makerviet/maker-bot/README.md

# MakerBot - Thiết kế phần cứng cho VIA MakerBot các phiên bản

Các thiết kế của mạch Makerbot sẽ được cập nhật trong thời gian tới.
- MakerBot Mini.
- MakerBot V2, V3.

Tài liệu dự án: <https://via.makerviet.org/>.
