makerviet/maker-bot/images/DC2.jpg

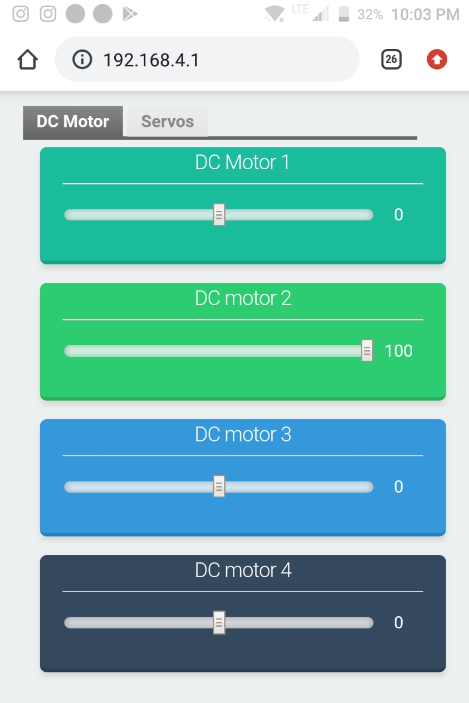
images/DC2.jpg
