makerviet/maker-bot/images/img1.jpg

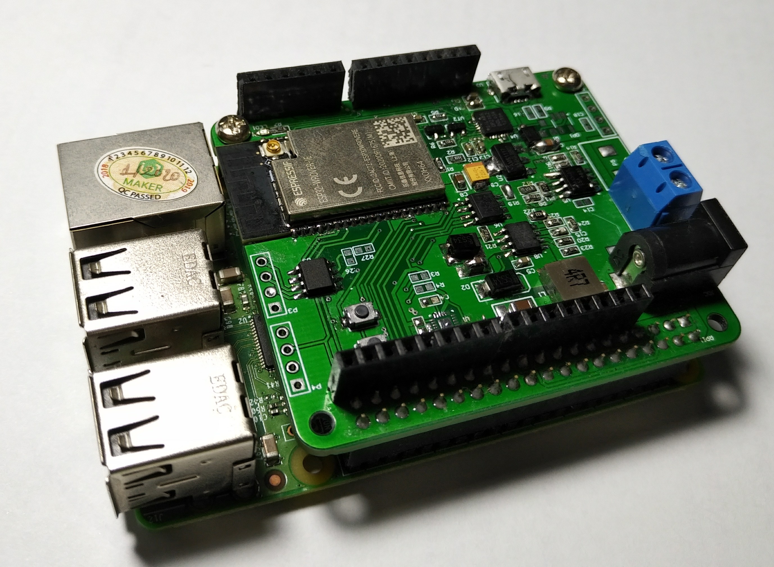
images/img1.jpg
