makerviet/maker-bot/images/img2.jpg

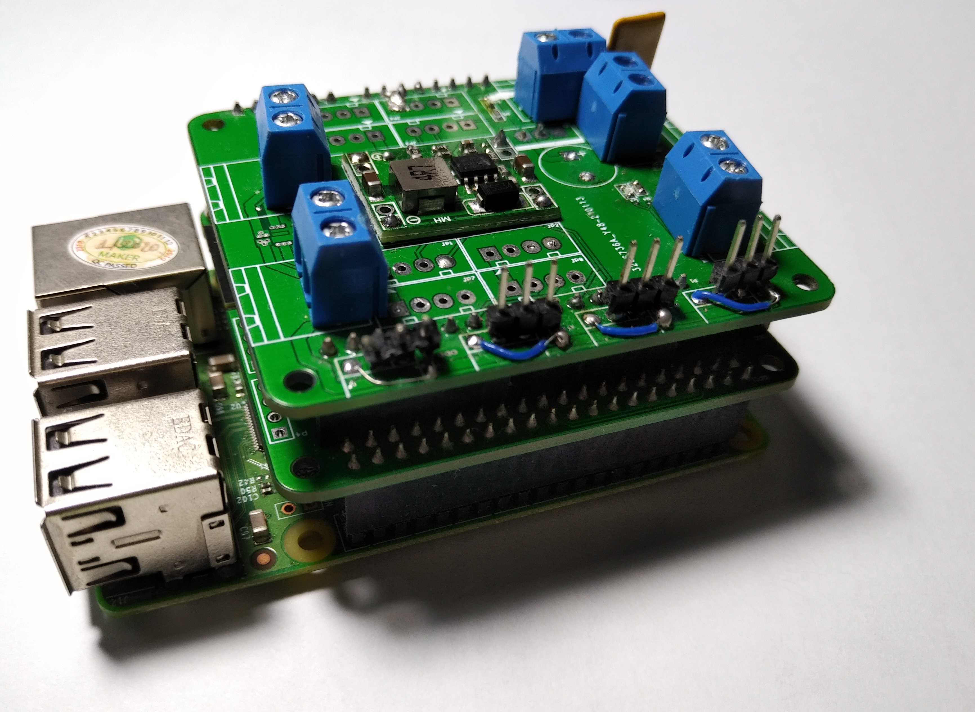
images/img2.jpg
