makerviet/maker-bot/images/motorshield_v2.jpg

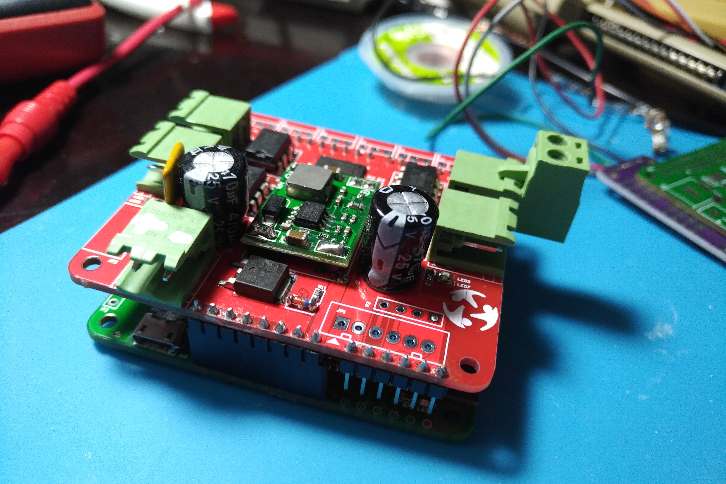
images/motorshield_v2.jpg
