makerviet/maker-bot/firmware/MakerBotwPS2/README.md

# ESP32 firmware example
## ESP32 PS2 controller bot
### Libary requirement: 
### ES32 PS2 controller https://github.com/MyArduinoLib/Arduino-PS2X-ESP32
Updating...
