makerviet/maker-bot/docs/Tutorial_Docs/Cài-đặt-thư-viện-ESP32-trên-Arduino-IDE.pdf

## Cài đặt thư viện ESP32 trên Arduino IDE

*lưu ý: đã cài đặt Arduino IDE
Hãy đảm bảo phiên bản Arduino IDE được cài đặt trên máy là mới nhất.

Cài đặt thư viện cho ESP32

1, Để cài đặt thư viện hỗ trợ cho ESP8266 đầu tiên các bạn vào File -> Preferences.

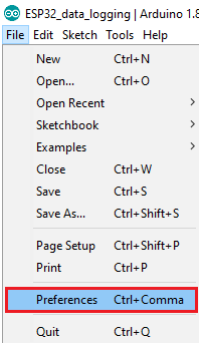
[picture p48: figure]

2, Tại “Additional Board Manager URLs”
nhập https://dl.espressif.com/dl/package_esp32_index.json – Chú ý: nếu đã tồn tại một URL hãy phân cách bằng dấu “,”

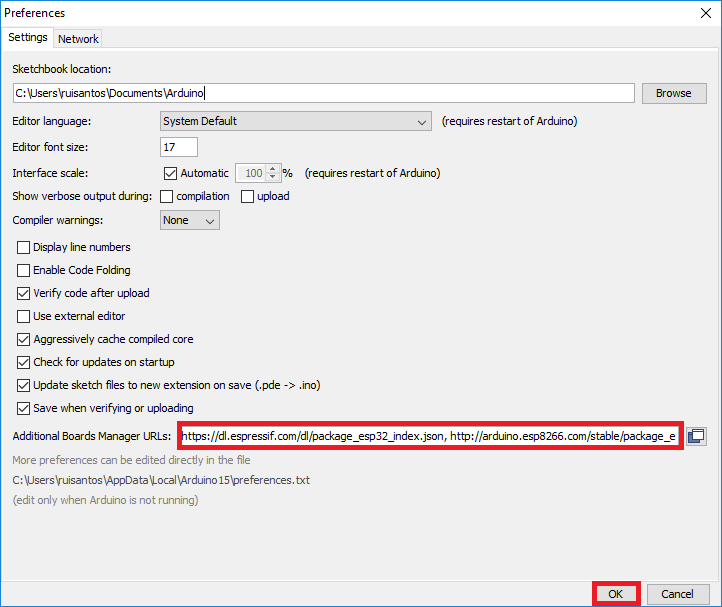
[picture p49: figure]
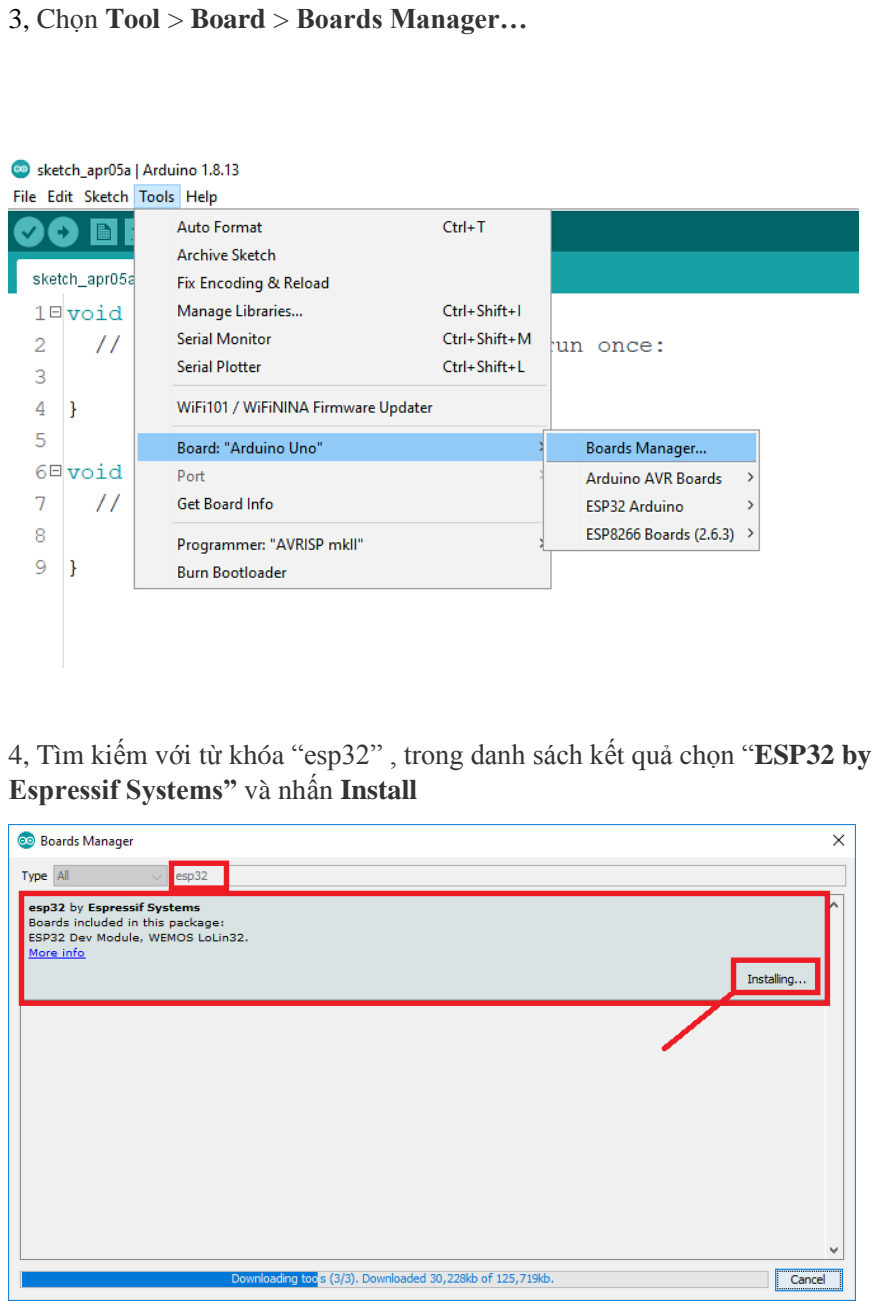
[picture p50: page 3]

3, Chọn Tool > Board > Boards Manager…

4, Tìm kiếm với từ khóa “esp32” , trong danh sách kết quả chọn “ESP32 by Espressif Systems” và nhấn Install
