makerviet/maker-bot/hardware/Legacy versions/Makerbot_Proto/VIA6.1.PcbDoc.htm

Reporting Options

# File in Newer Format

Date | : | 4/23/2022
Time | : | 10:49:37 PM
Filename | : | D:\Makerbot\MakerBot_git\maker-bot\hardware\Layout\Makerbot_Proto\VIA6.1.PcbDoc

Version | Warning
Release 15.1 | CAUTION - Support Multi-line PCB Text added.
Release 16.0 | CAUTION - Pad/Via hole size tolerance value added.
Release 17.0 | CAUTION - Component parameters added.
Release 17.0 | CAUTION - Support of backdrilling
Release 17.1 | CAUTION - Support of waived violations
Release 17.1 | CAUTION - Support of object specific keepouts
Release 20.0 | CAUTION - Support of propagation delay for primitives

This file was generated by a later version of the software
