makerviet/maker-bot/hardware/Legacy versions/Makerbot_V1.1/VIA5.PcbDoc.htm

Reporting Options

# File in Previous Format

Date | : | 7/10/2021
Time | : | 5:24:19 PM
Filename | : | D:\Makerbot\MakerBot_git\maker-bot\hardware\Layout\Makerbot_V1.1\VIA5.PcbDoc

Version | Warning

This file was generated by an earlier version of the software
