makerviet/maker-bot/images/makerboot2.png

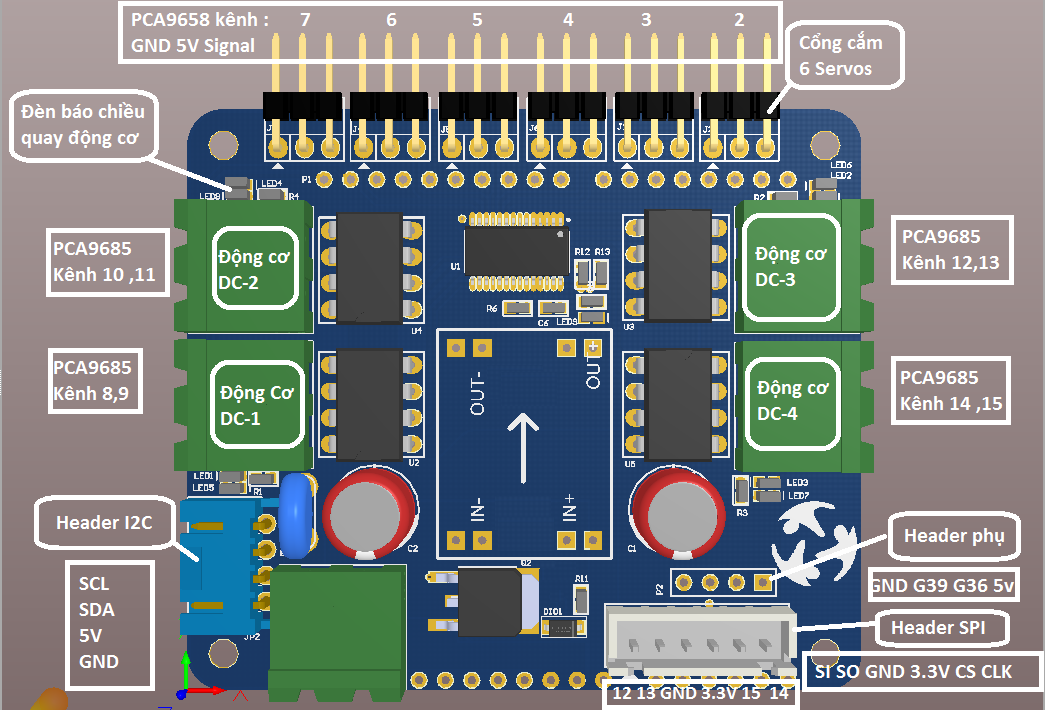
images/makerboot2.png
