makerviet/maker-bot/hardware/Makerbot BANHMI (VRC 2022)/Makerbot BANHMI schematic.pdf

ESP32 | LED

# ESP32 MAIN

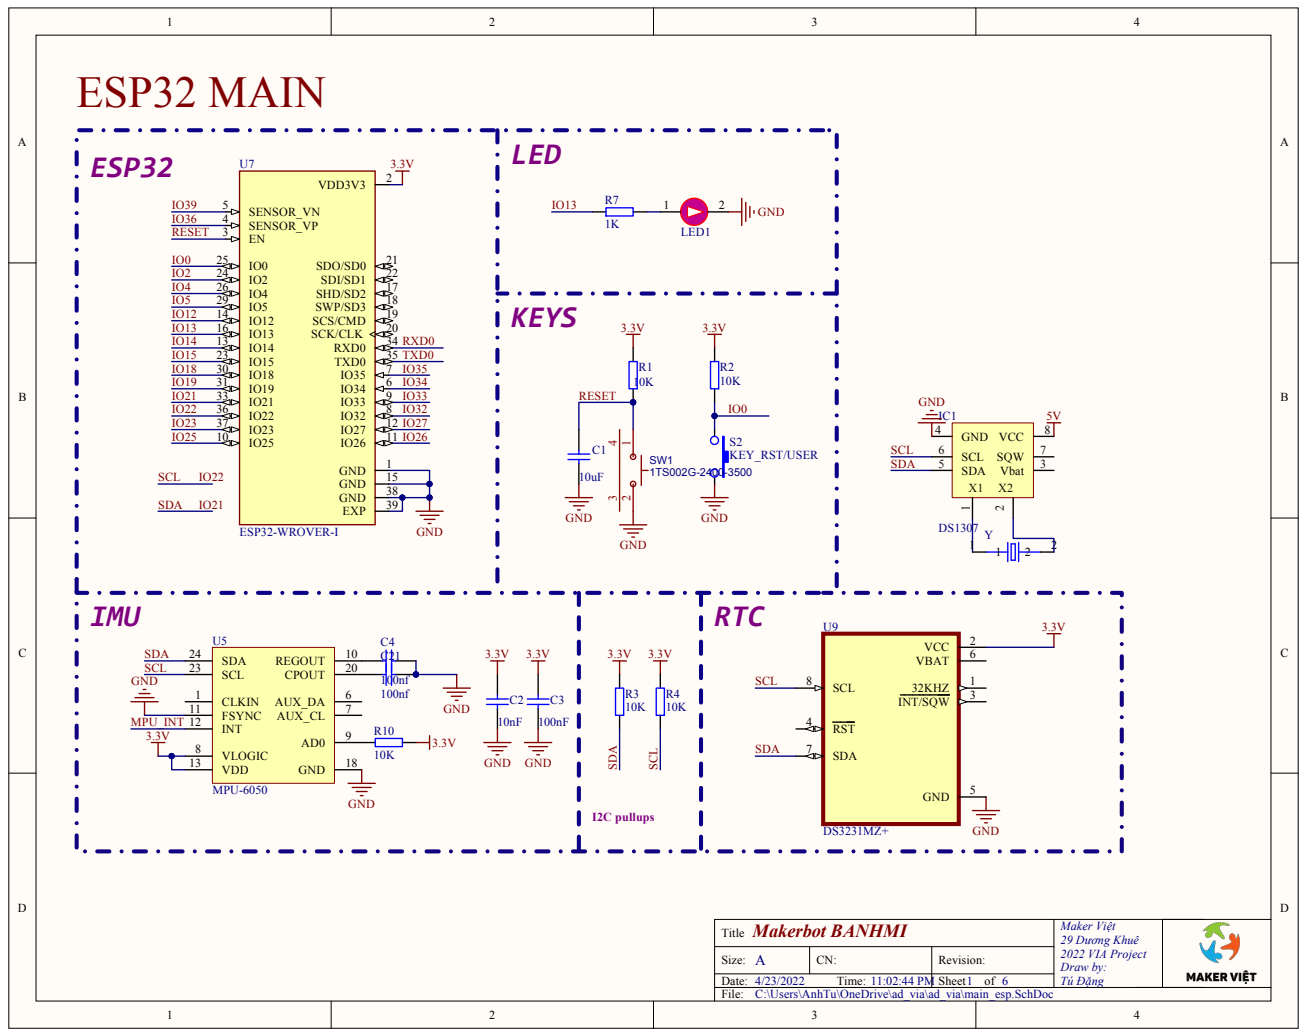
[picture p52: page 1]

LED1

KEYS 3.3V | 3.3V R1 10K | R2 10K

C:\Users\AnhTu\OneDrive\ad_via\ad_via\main_esp.SchDoc

# UNO HEADER PI HEADER

# I2C & UART

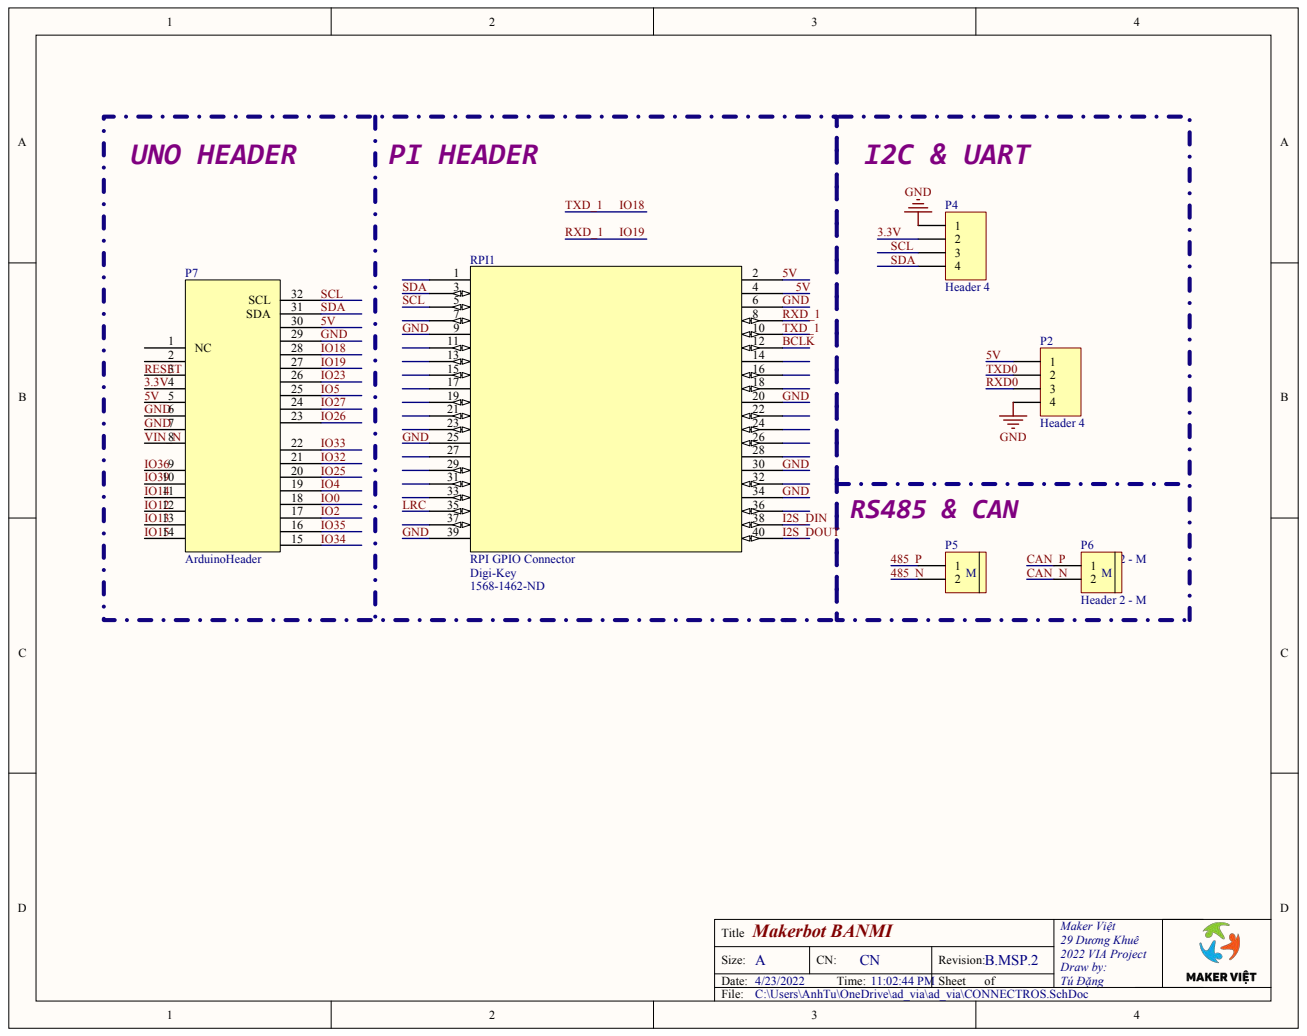
[picture p53: page 2]
Maker Việt 29 Dương Khuê; Tú Đặng; Makerbot BANMI; B.MSP.2; Title; SDA SCL; RXD_1 TXD_1; GND; CAN_P; CAN_N; RS485 & CAN; 3.3V 5V GND GND VIN_N; GPIO2 (I2C SDA) 3; GPIO3 (I2C SCL) 5; GPIO4 7; UART0 TX; GND 9; UART0 RX; GPIO17 11; GPIO18; GPIO27 13; GPIO22 15; GPIO23; GPIO24; GPIO10 (SPI0 MOSI) 19; GPIO9 (SPI0 MISO) 21; GPIO25; GPIO11 (SPI0 SCLK) 23; GPIO8 (SPI0 CS0); GND 25; GPIO7 (SPI0 CS1); RSVD 27; RSVD; GPIO5 29; GPIO6 31; GPIO12; GPIO13 33; GPIO19 (SPI1 MISO) 35; GPIO16 (SPI1 CS0)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

RPI GPIO Connector
Digi-Key

C:\Users\AnhTu\OneDrive\ad_via\ad_via\CONNECTROS.SchDoc

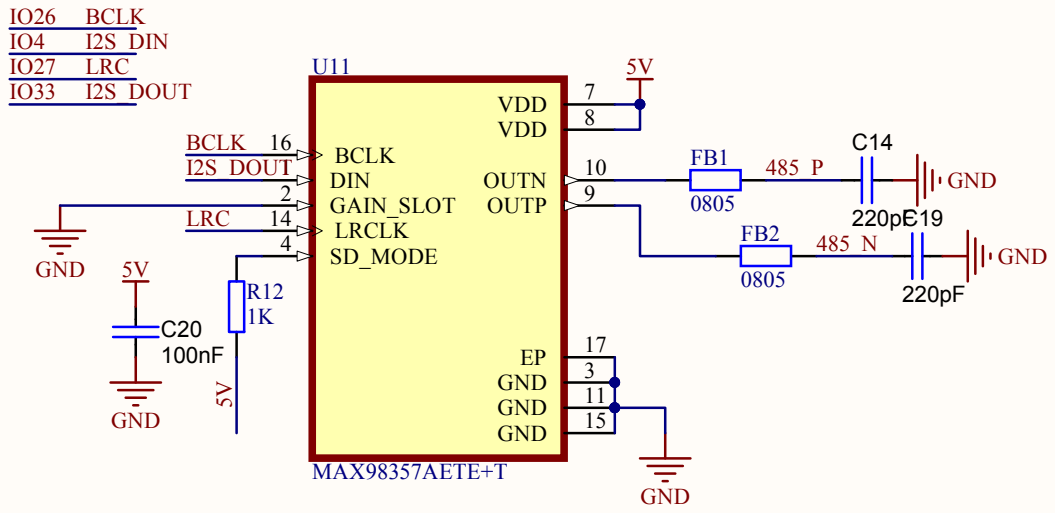
[picture p54: page 3]
Maker Việt 29 Dương Khuê; Makerbot BANMI; Title; BCLK 16 DIN 1 GAIN_SLOT 2 LRCLK 14 SD_MODE 4; VDD; OUTN; OUTP; GND; MAX98357AETE+T; BCLK; LRC; I2S_DIN; BCLK I2S_DOUT; I2S_DOUT

C:\Users\AnhTu\OneDrive\ad_via\ad_via\Mic_SPK2.SchDoc

# 12v to 5v

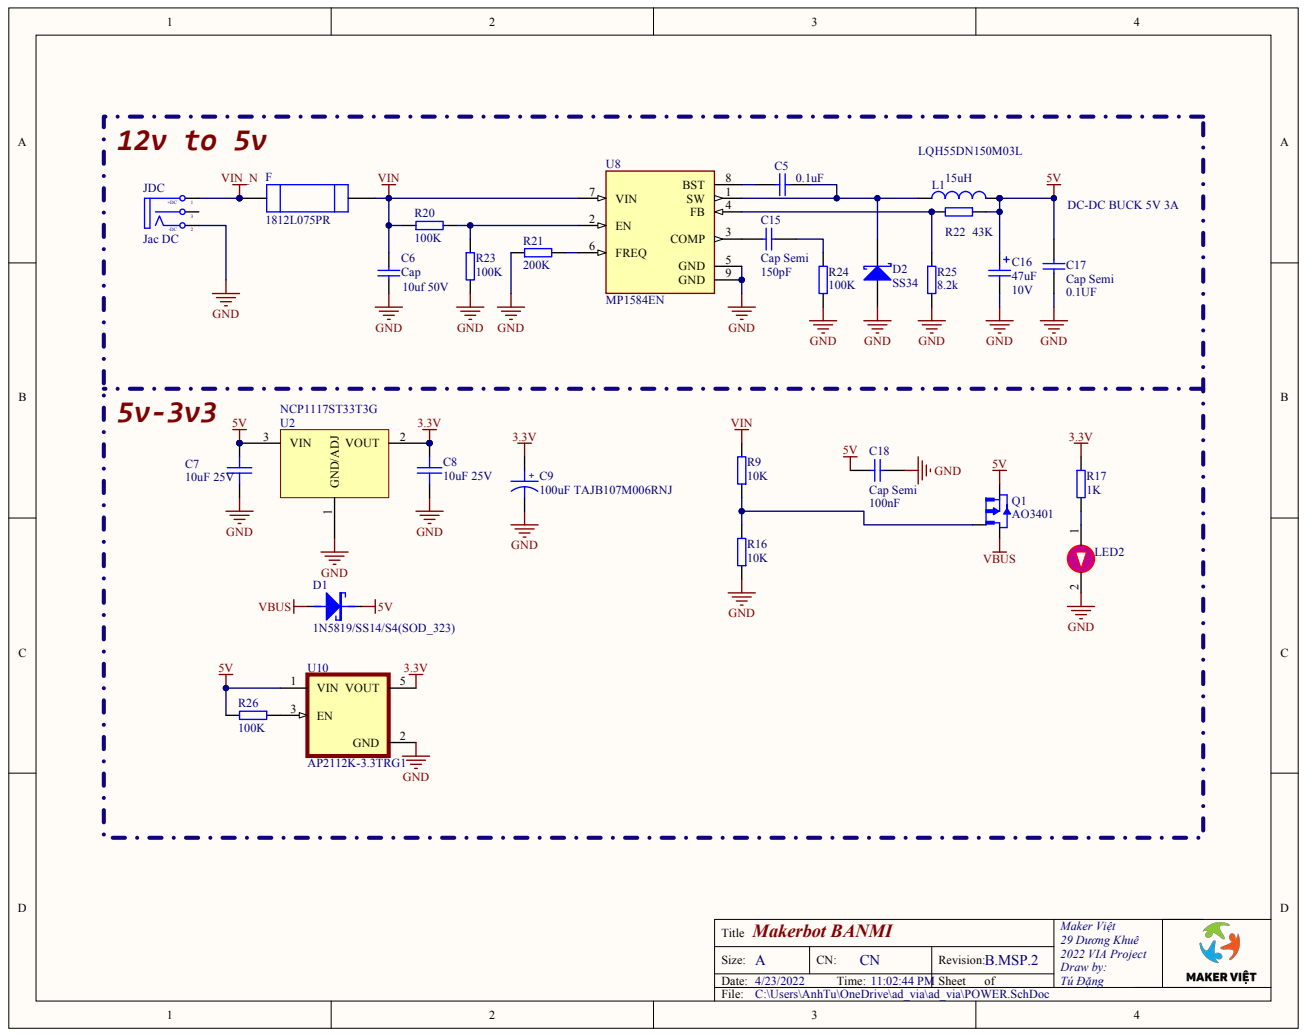
[picture p55: page 4]

C:\Users\AnhTu\OneDrive\ad_via\ad_via\POWER.SchDoc

# CAN

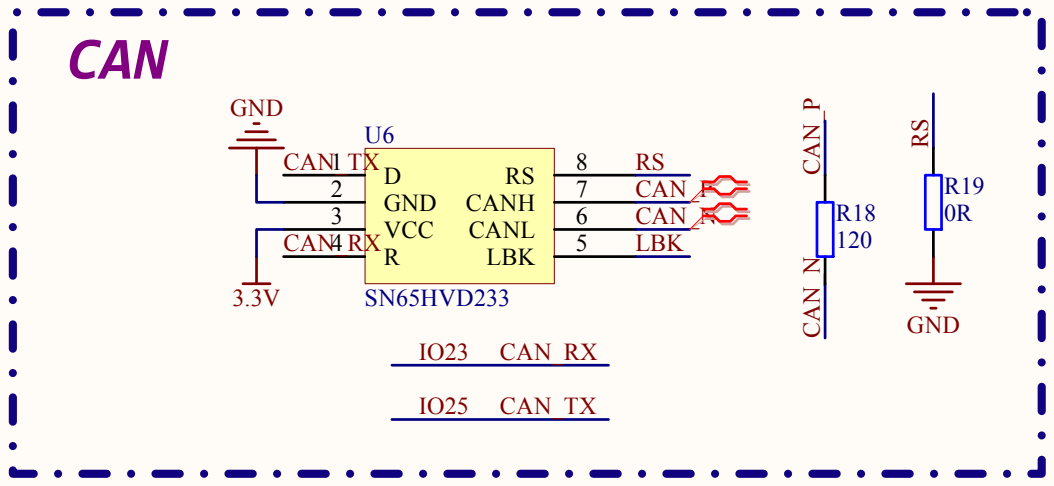
[picture p56: page 5]
Maker Việt 29 Dương Khuê; Makerbot BANMI; Title; D 1 GND 2 VCC 3 R 4; CANH; CANL; LBK; SN65HVD233; GND; CAN_P CAN_N; CAN_TX; CAN_RX; RS GND

C:\Users\AnhTu\OneDrive\ad_via\ad_via\RS485_CAN.SchDoc

# USB TO UART AND AUTO DOWNLOAD

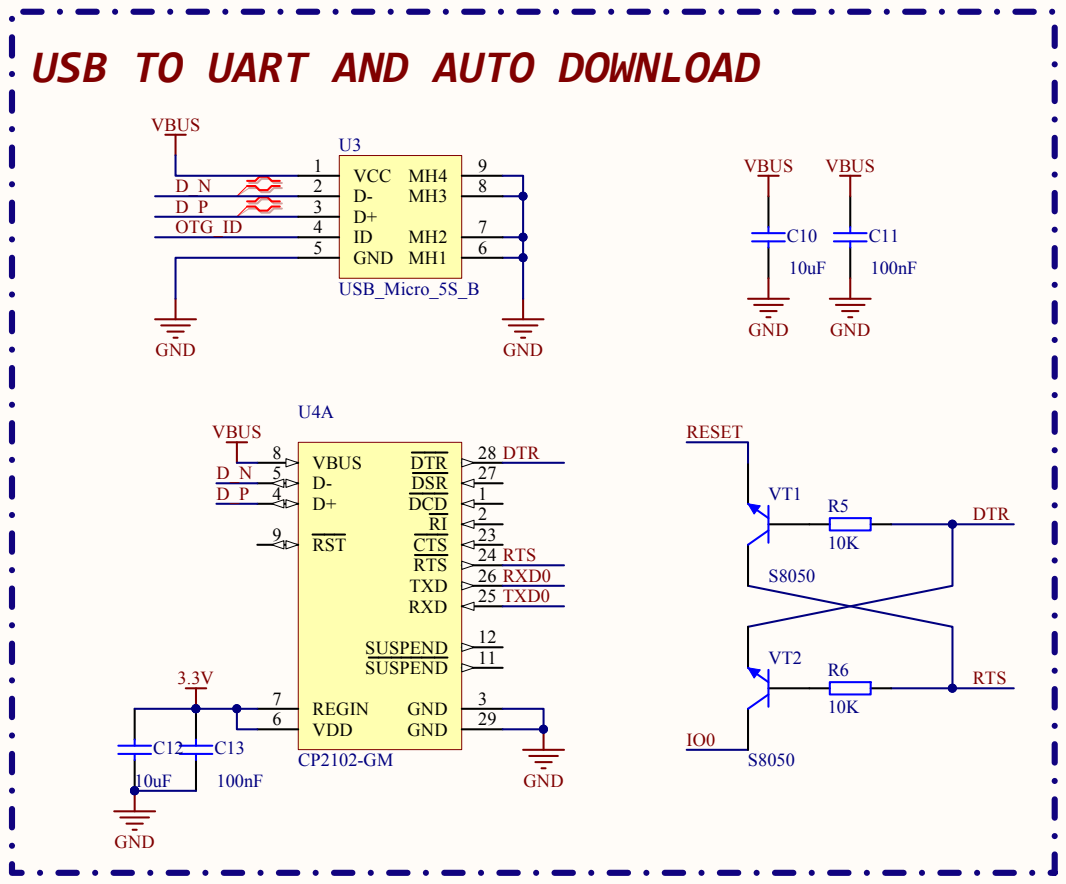
[picture p57: page 6]

C:\Users\AnhTu\OneDrive\ad_via\ad_via\Usb_To_UART.SchDoc
