makerviet/maker-bot/hardware/Makerbot BANHMI (VRC 2022)/Motorshield schematic.pdf

PCA9685 | Servo Out

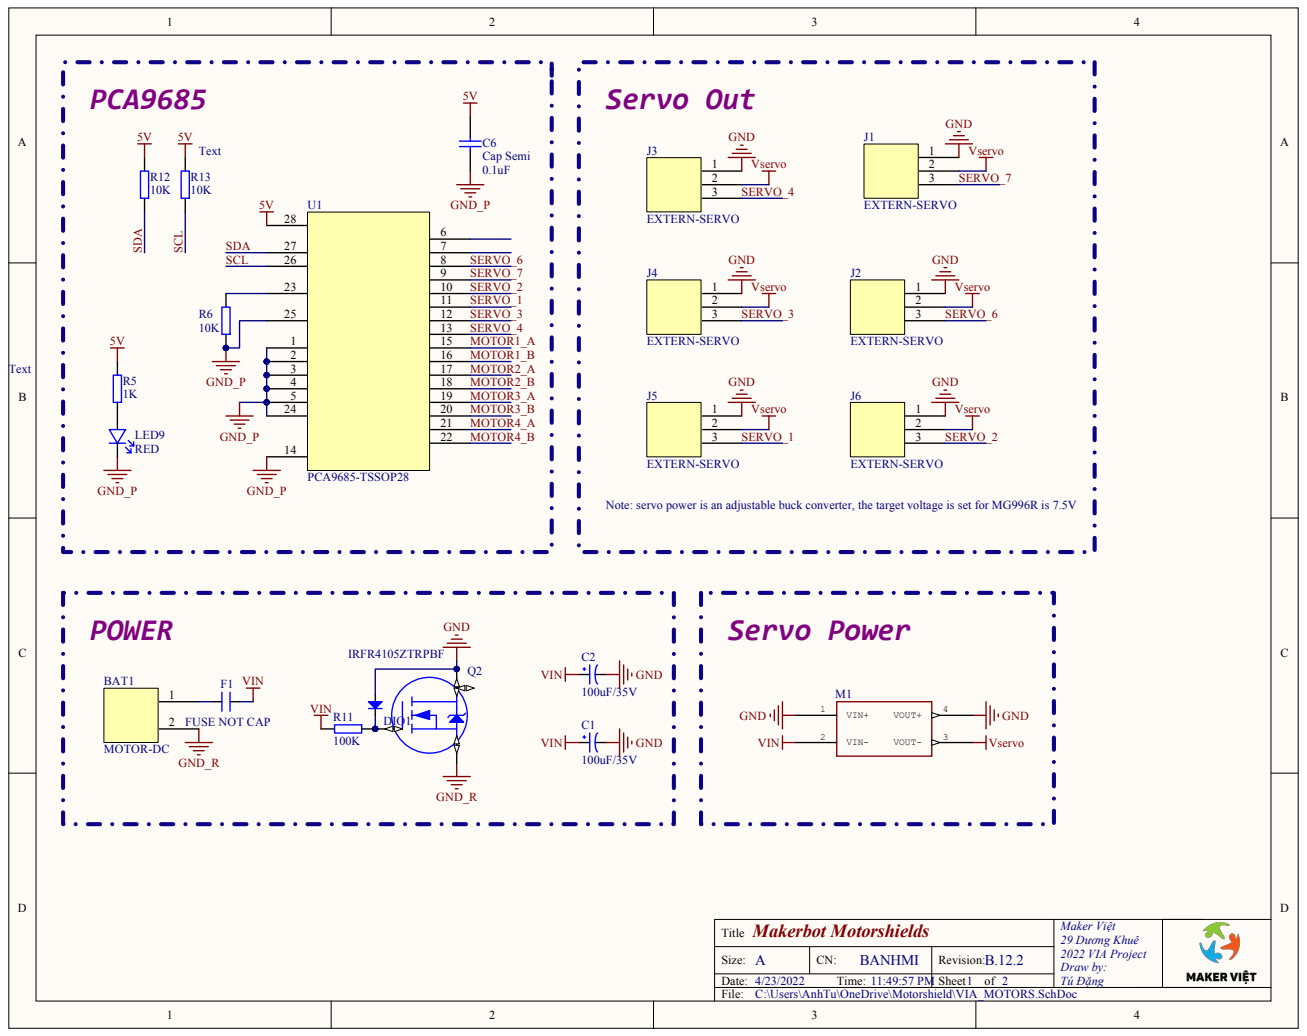
[picture p58: page 1]

Note: servo power is an adjustable buck converter, the target voltage is set for MG996R is 7.5V

C:\Users\AnhTu\OneDrive\Motorshield\VIA_MOTORS.SchDoc

# Arduino header

# H bridges

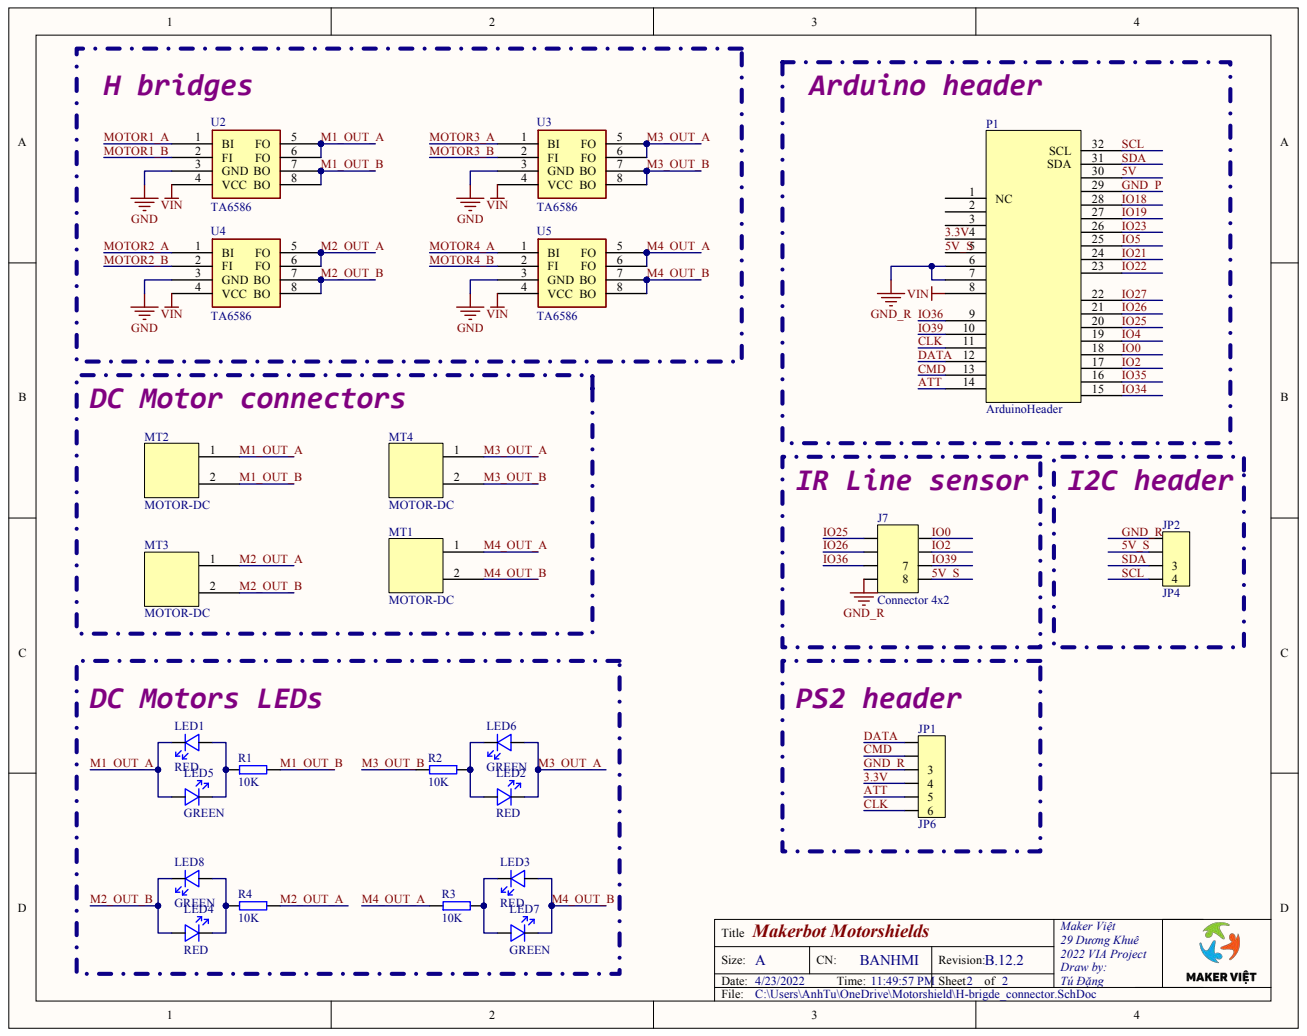
[picture p59: page 2]

C:\Users\AnhTu\OneDrive\Motorshield\H-brigde_connector.SchDoc
