makerviet/maker-bot/hardware/Legacy versions/Schematics/makerBot.pdf

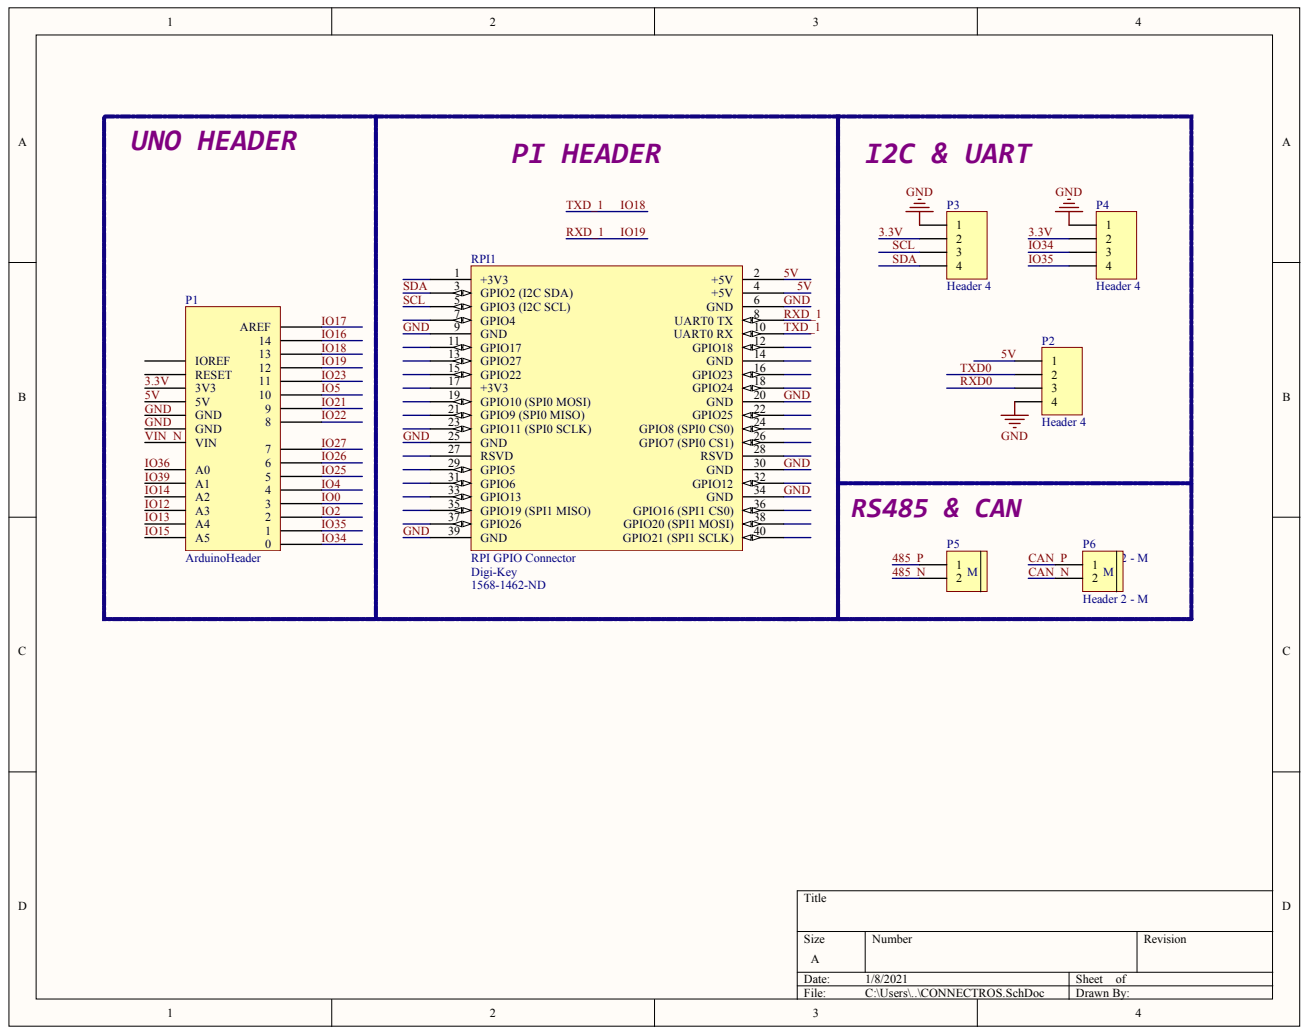
[picture p60: page 1]

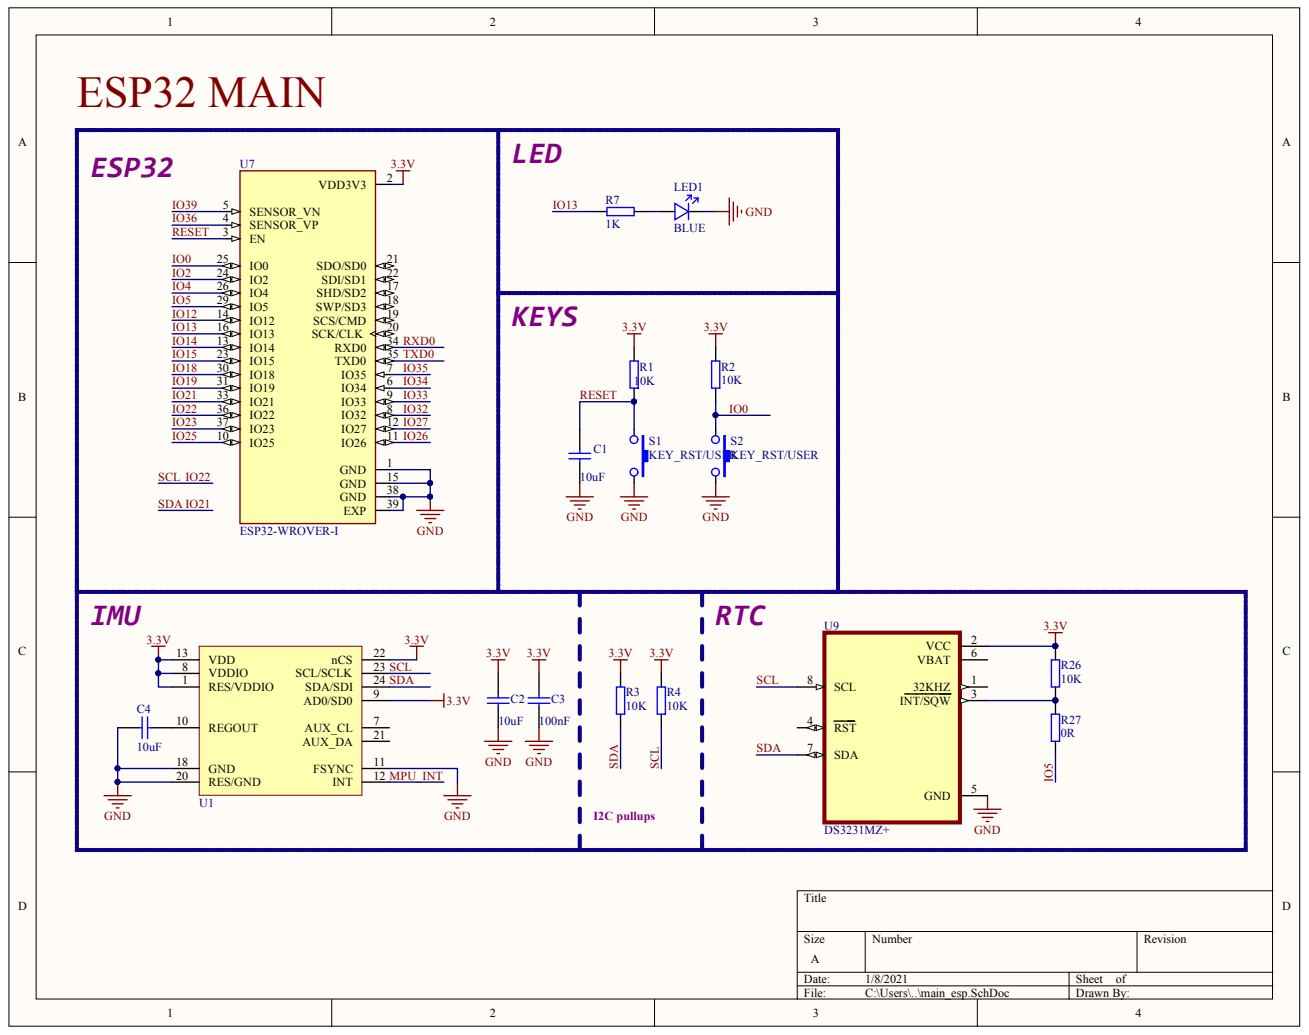
[picture p61: page 2]

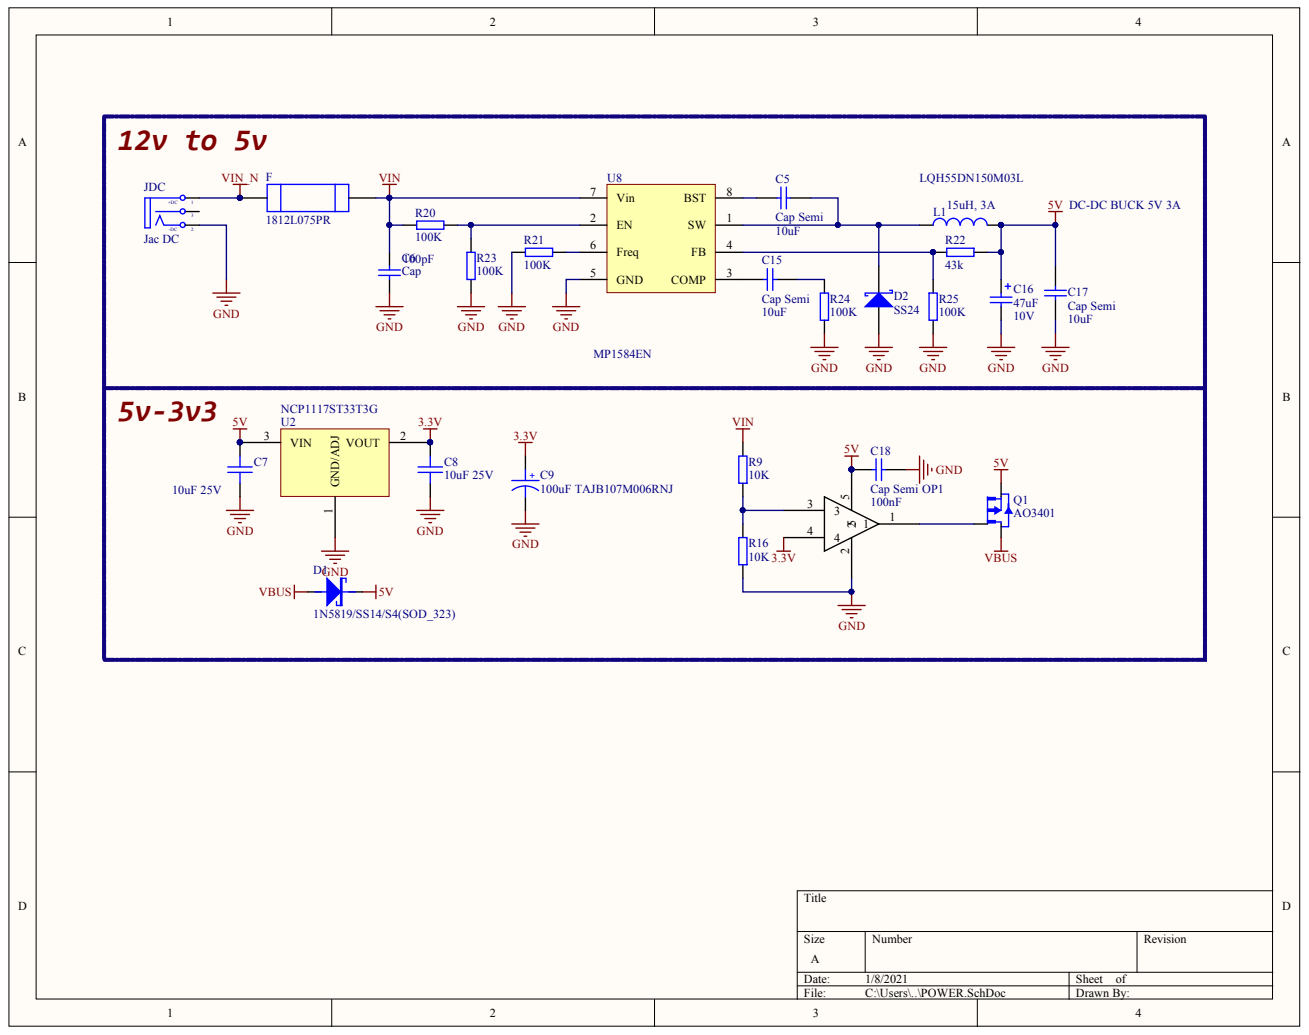
[picture p62: page 3]

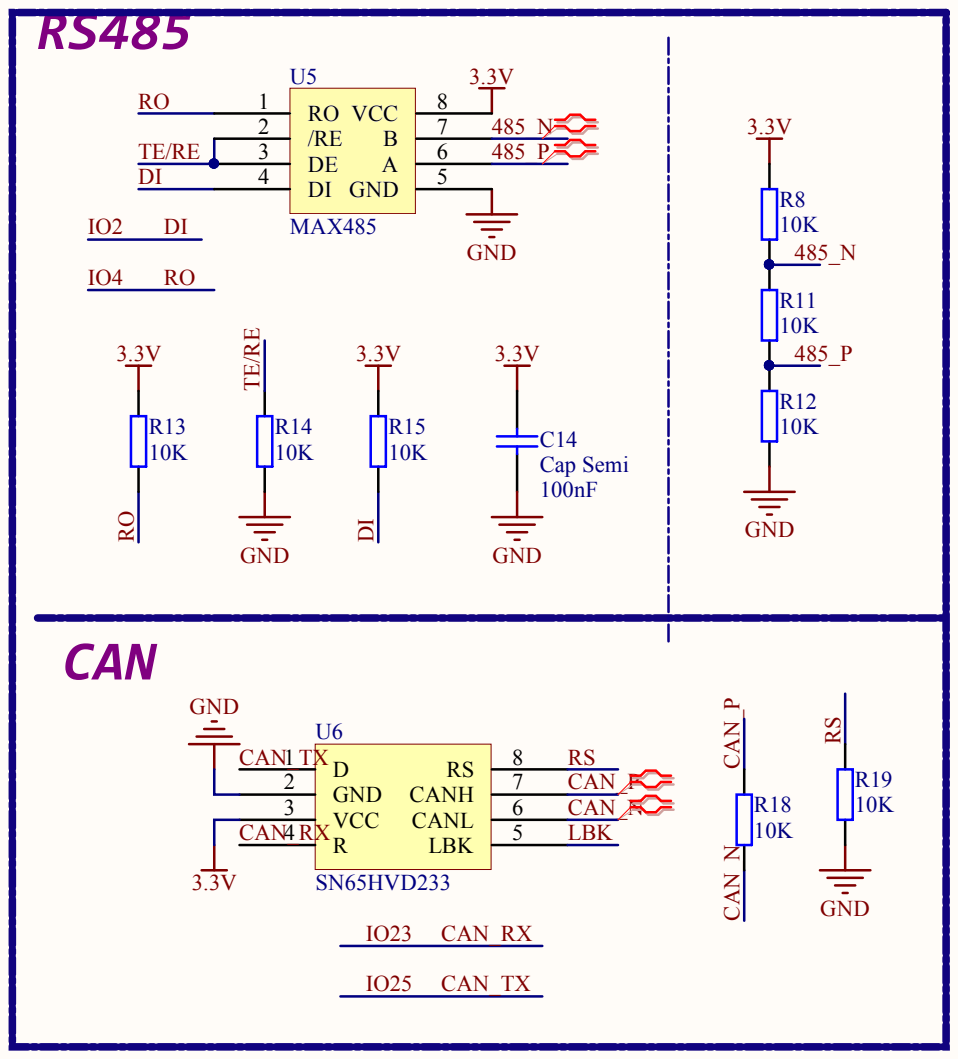
[picture p63: page 4]

VCC 3
CAN_RX | R 4

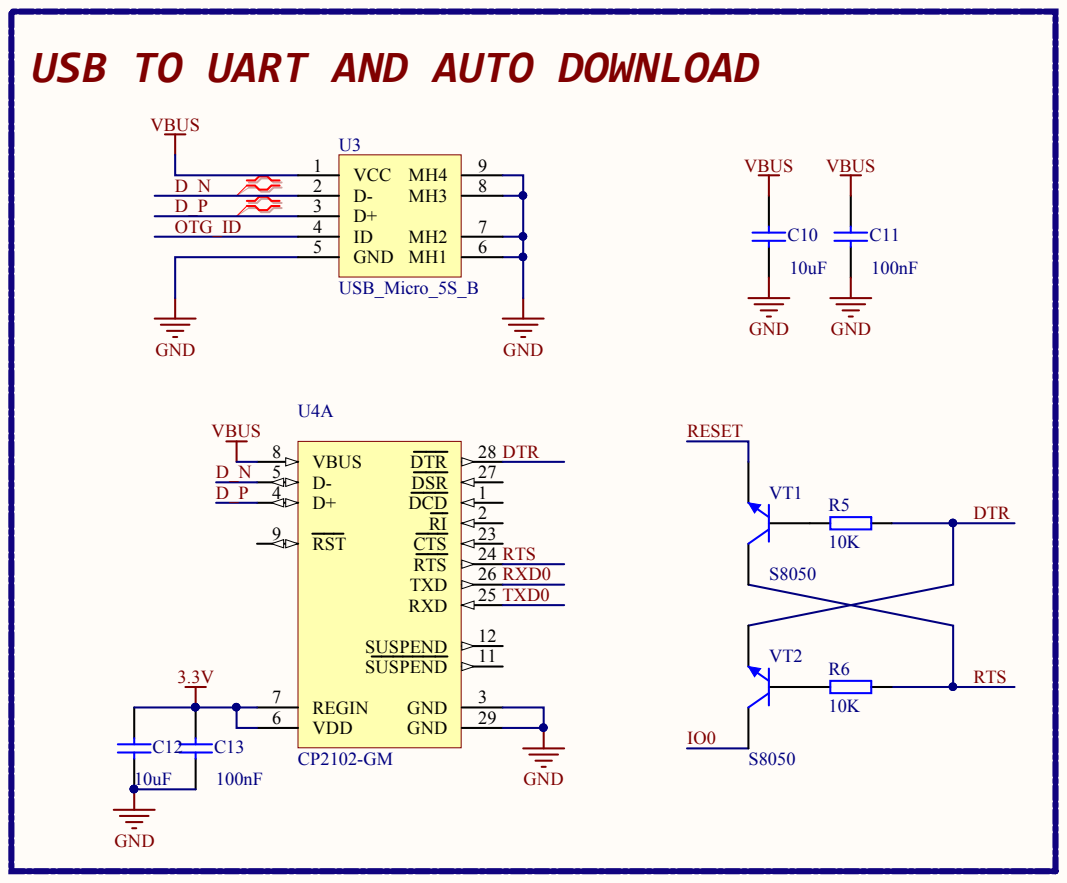
[picture p64: page 5]

USB TO UART AND AUTO DOWNLOAD

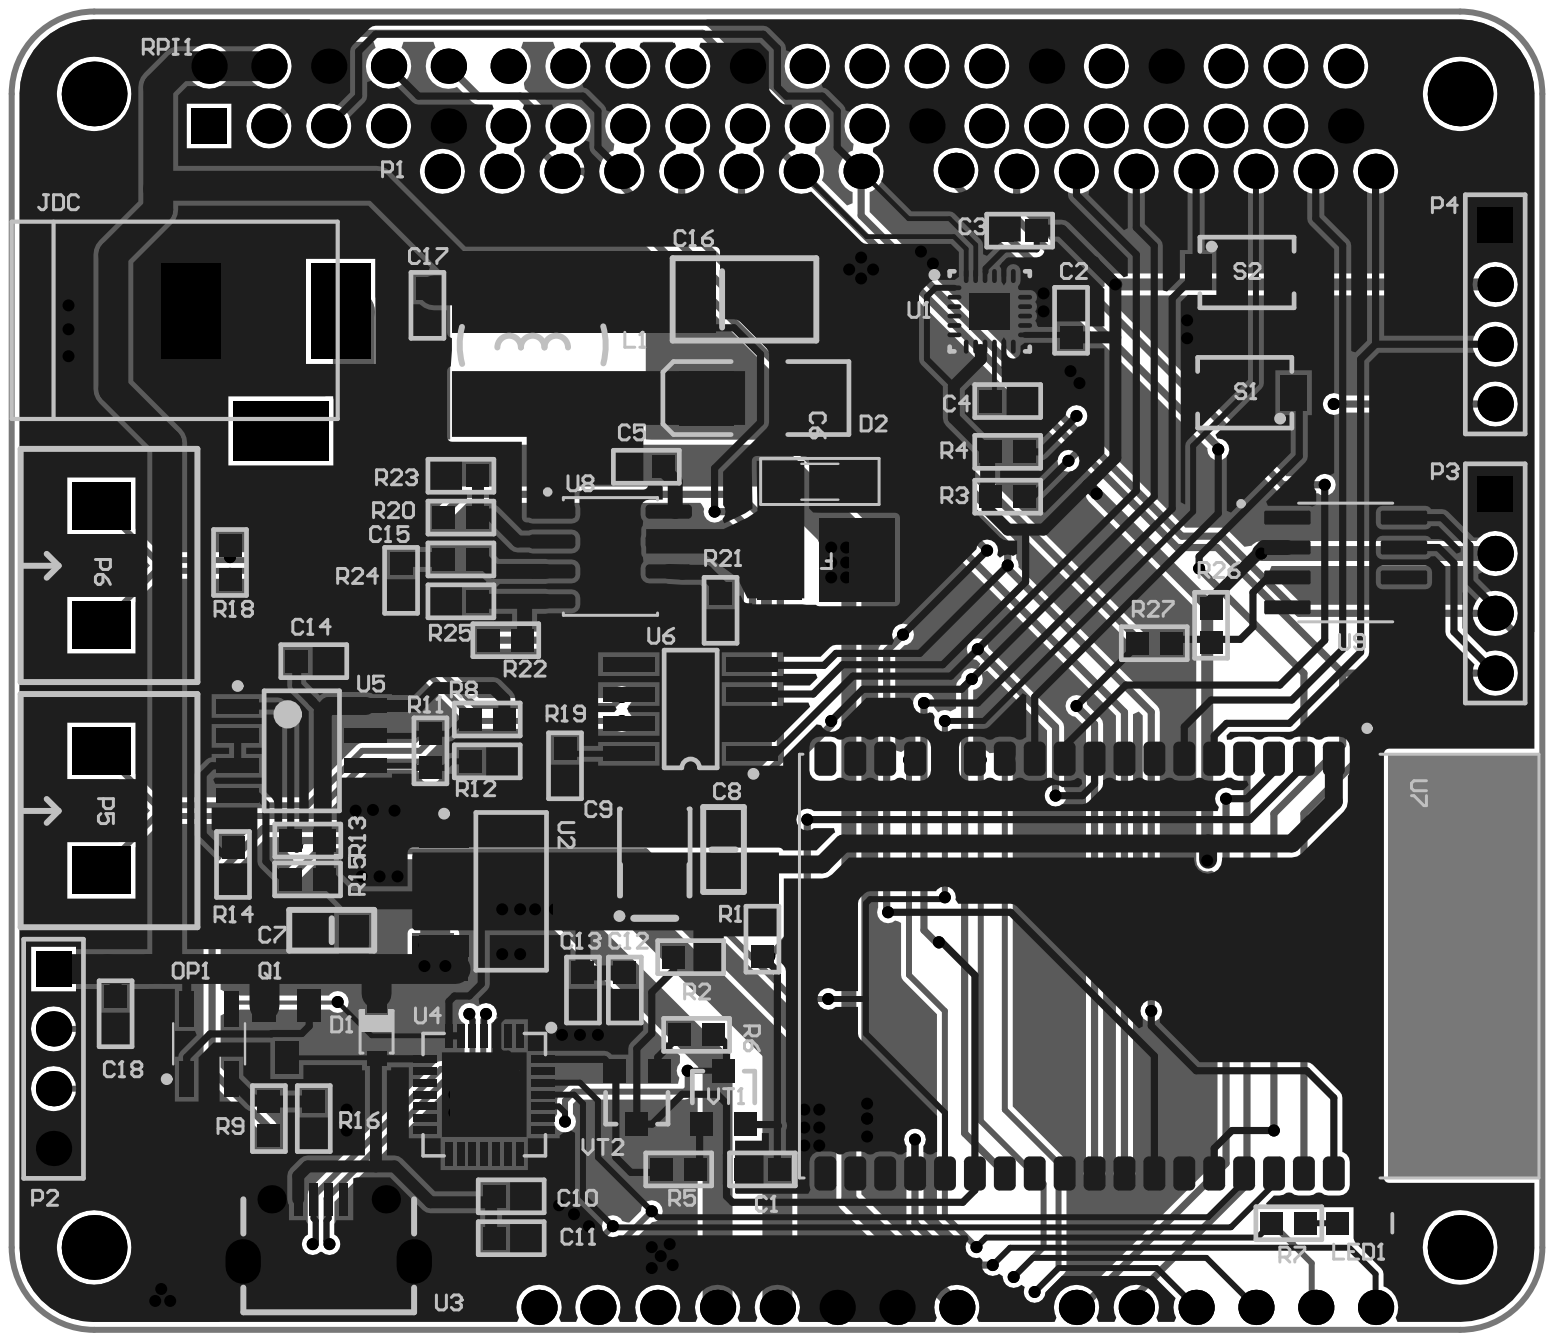
[picture p65: page 6]
