makerviet/maker-bot/hardware/Legacy versions/Schematics/Motorshield.pdf

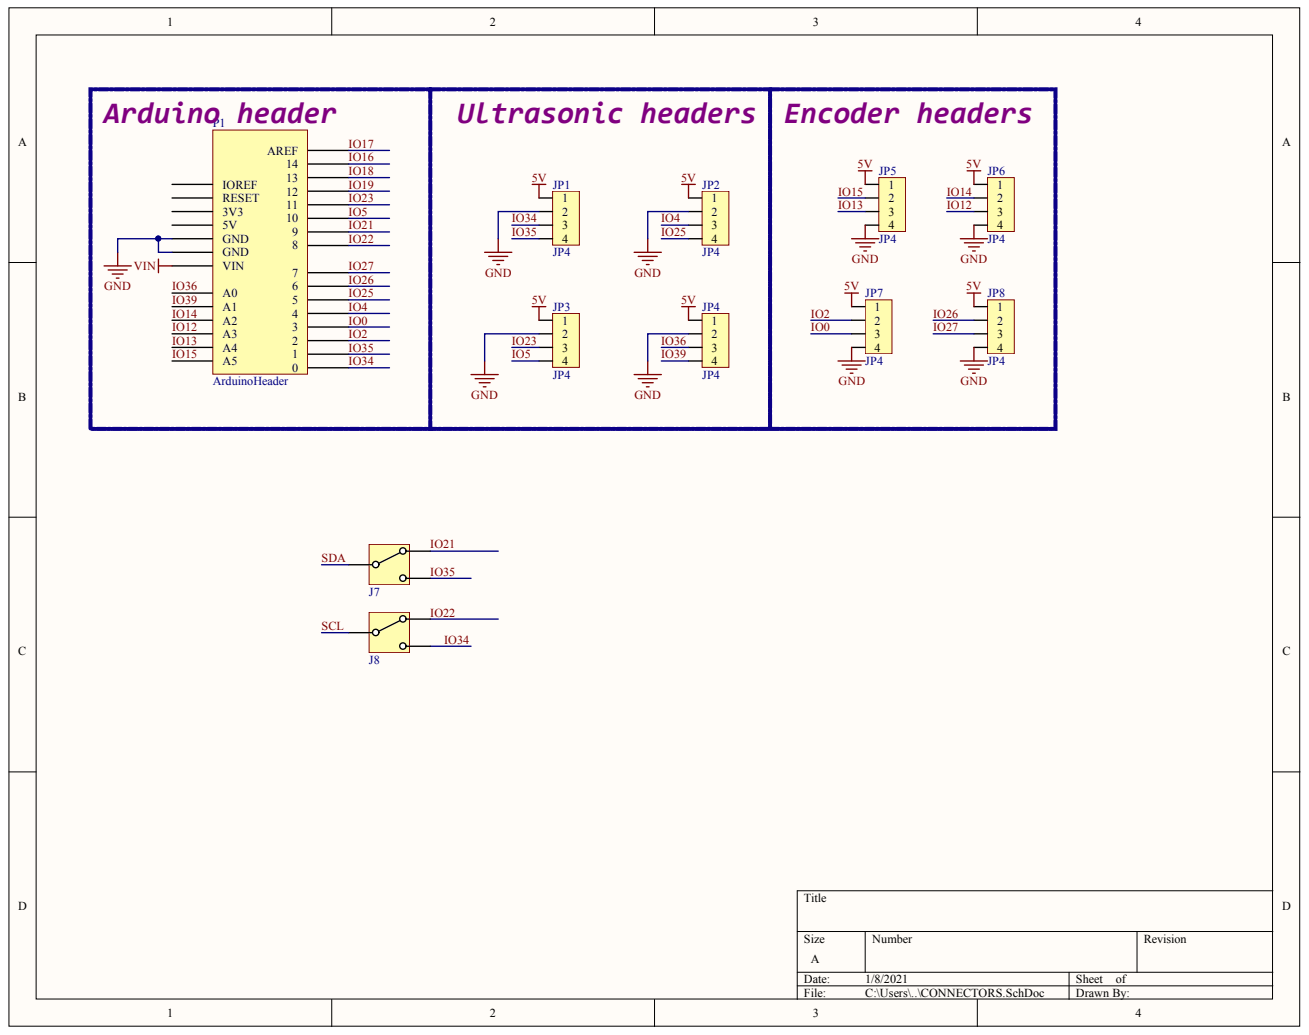
[picture p66: page 1]

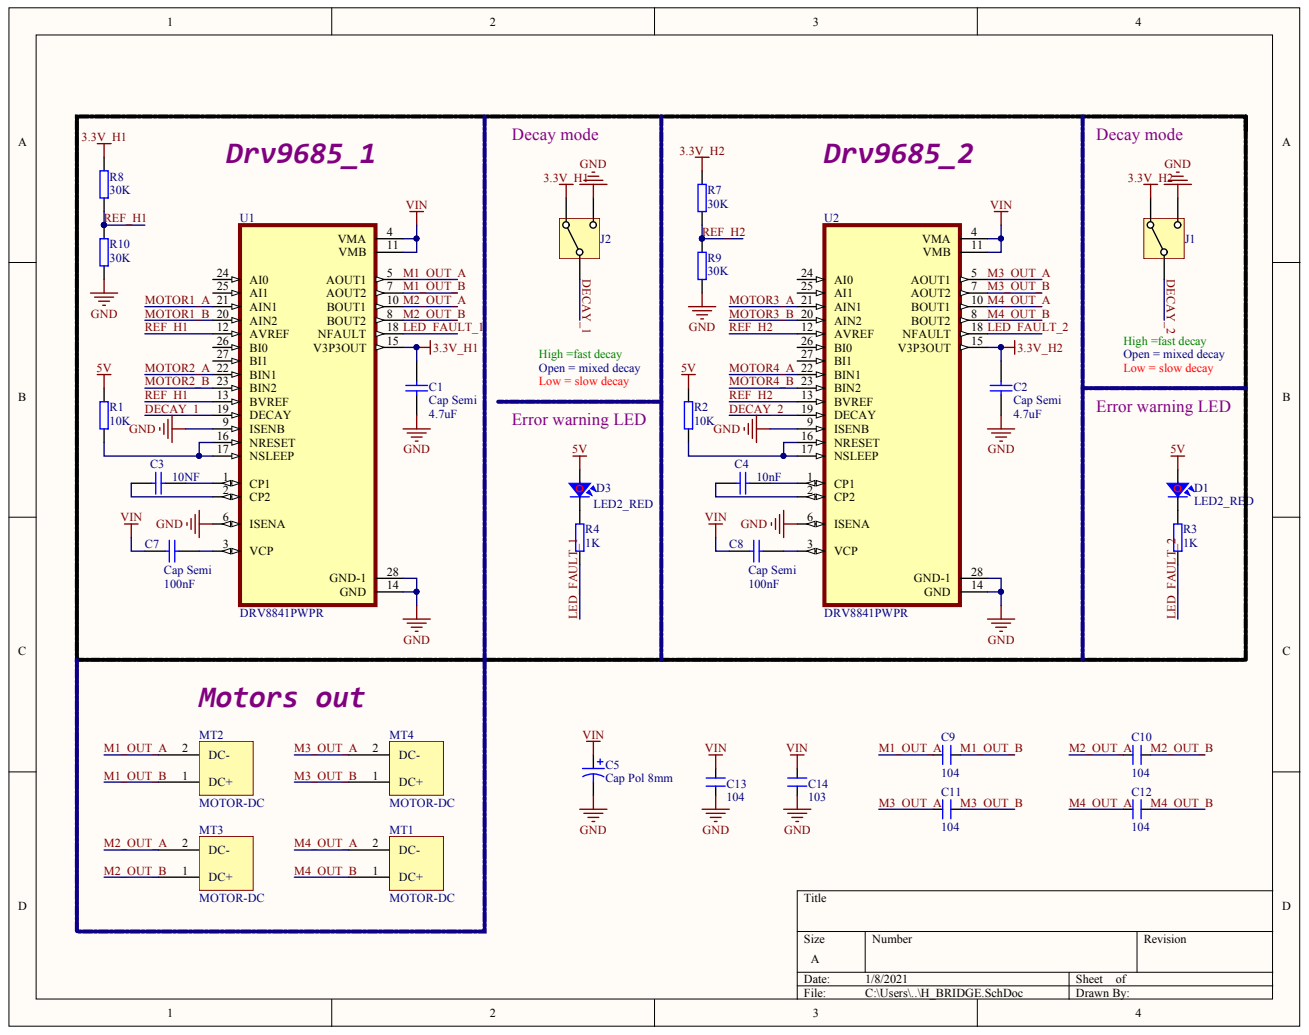
[picture p67: page 2]

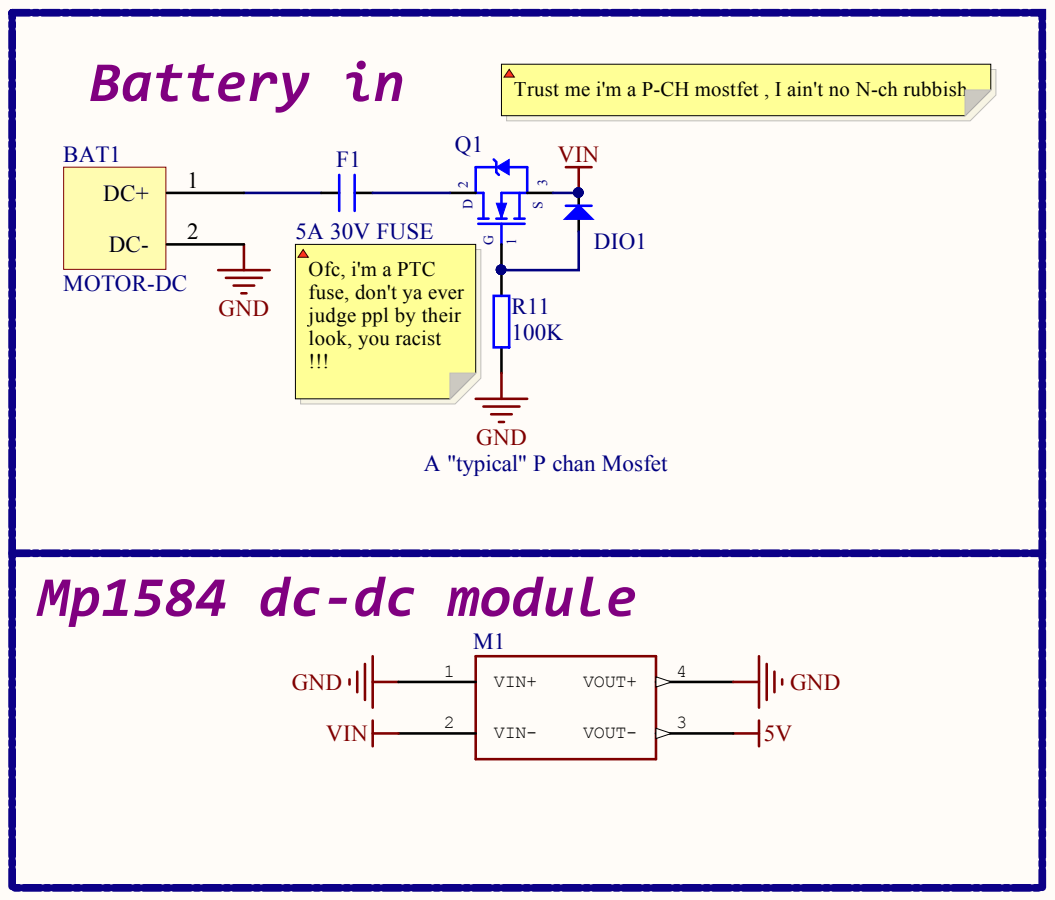
[picture p68: page 3]

Trust me i'm a P-CH mostfet , I ain't no N-ch rubbish

Ofc, i'm a PTC
fuse, don't ya ever
judge ppl by their
look, you racist

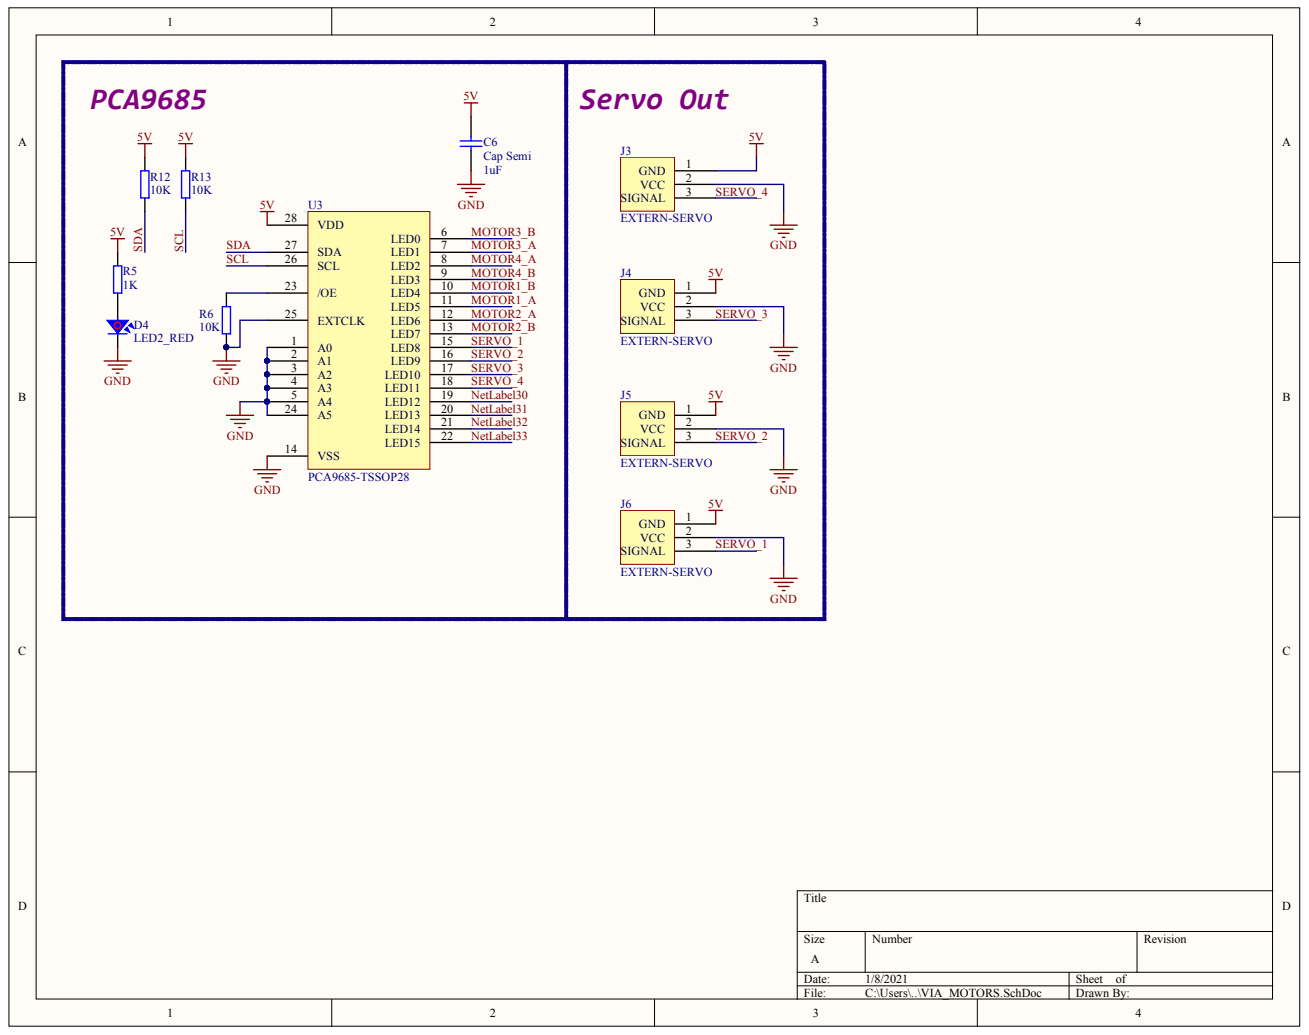
[picture p69: page 4]

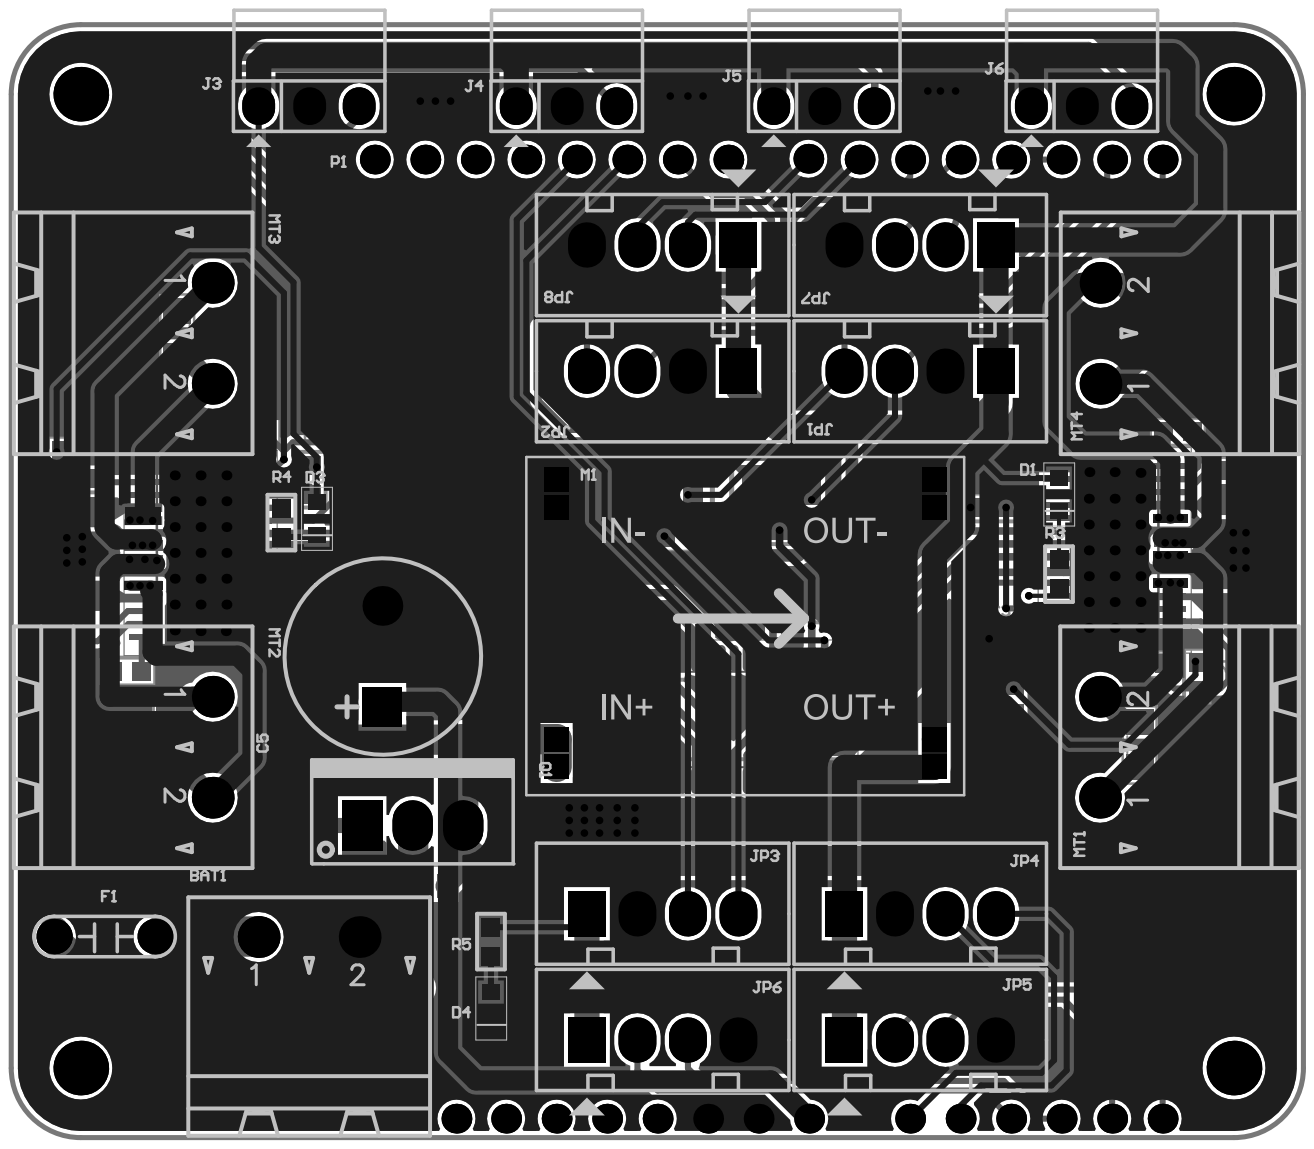
[picture p70: page 5]
