makerviet/maker-bot/(list of files, drawings)

Other design files:
hardware/Legacy versions/Makerbot/ad_via.PrjPcb
hardware/Legacy versions/Makerbot/CONNECTROS.SchDoc
hardware/Legacy versions/Makerbot/main_esp.SchDoc
hardware/Legacy versions/Makerbot/POWER.SchDoc
hardware/Legacy versions/Makerbot/RS485_CAN.SchDoc
hardware/Legacy versions/Makerbot/Usb_To_UART.SchDoc
hardware/Legacy versions/Makerbot_Proto/ad_via.PrjPcb
hardware/Legacy versions/Makerbot_Proto/CONNECTROS.SchDoc
hardware/Legacy versions/Makerbot_Proto/main_esp.SchDoc
hardware/Legacy versions/Makerbot_Proto/Mic_SPK2.SchDoc
hardware/Legacy versions/Makerbot_Proto/Mic_SPK.SchDoc
hardware/Legacy versions/Makerbot_Proto/POWER.SchDoc
hardware/Legacy versions/Makerbot_Proto/RS485_CAN.SchDoc
hardware/Legacy versions/Makerbot_Proto/Usb_To_UART.SchDoc
hardware/Legacy versions/Makerbot_V1.1/ad_via.PrjPcb
hardware/Legacy versions/Makerbot_V1.1/CONNECTROS.SchDoc
hardware/Legacy versions/Makerbot_V1.1/main_esp.SchDoc
hardware/Legacy versions/Makerbot_V1.1/POWER.SchDoc
hardware/Legacy versions/Makerbot_V1.1/RS485_CAN.SchDoc
hardware/Legacy versions/Makerbot_V1.1/Usb_To_UART.SchDoc
hardware/Legacy versions/Motorshield/ad_motor.PcbDoc
hardware/Legacy versions/Motorshield/ad_via_motors.PrjPcb
hardware/Legacy versions/Motorshield/CONNECTORS.SchDoc
hardware/Legacy versions/Motorshield/H_BRIDGE.SchDoc
hardware/Legacy versions/Motorshield/power.SchDoc
hardware/Legacy versions/Motorshield/VIA_MOTORS.SchDoc
hardware/Legacy versions/Motorshield_V2/ad_motor3.PcbDoc
hardware/Legacy versions/Motorshield_V2/ad_via_motors.PrjPcb
hardware/Legacy versions/Motorshield_V2/H-brigde_connector.SchDoc
hardware/Legacy versions/Motorshield_V2/power.SchDoc
hardware/Legacy versions/Motorshield_V2/VIA_MOTORS.SchDoc
hardware/Makerbot BANHMI (VRC 2022)/Makerbot BANHMI/ad_via.PrjPcb
hardware/Makerbot BANHMI (VRC 2022)/Makerbot BANHMI/CONNECTROS.SchDoc
hardware/Makerbot BANHMI (VRC 2022)/Makerbot BANHMI/main_esp.SchDoc
hardware/Makerbot BANHMI (VRC 2022)/Makerbot BANHMI/Mic_SPK2.SchDoc
hardware/Makerbot BANHMI (VRC 2022)/Makerbot BANHMI/POWER.SchDoc
hardware/Makerbot BANHMI (VRC 2022)/Makerbot BANHMI/RS485_CAN.SchDoc
hardware/Makerbot BANHMI (VRC 2022)/Makerbot BANHMI/Usb_To_UART.SchDoc
hardware/Makerbot BANHMI (VRC 2022)/Motorshield for Makerbot BANHMI/ad_via_motors.PrjPcb
hardware/Makerbot BANHMI (VRC 2022)/Motorshield for Makerbot BANHMI/H-brigde_connector.SchDoc
hardware/Makerbot BANHMI (VRC 2022)/Motorshield for Makerbot BANHMI/VIA_MOTORS.SchDoc
