makerviet/maker-bot/(commit log)

2021-03-14 add PCB files
    [CONNECTORS.SchDoc, CONNECTROS.SchDoc, H_BRIDGE.SchDoc, POWER.SchDoc, RS485_CAN.SchDoc, Usb_To_UART.SchDoc, VIA_MOTORS.SchDoc, ad_motor.PcbDoc]
2021-03-17 Update Motorshield V2
    [CONNECTORS.SchDoc, CONNECTROS.SchDoc, H-brigde_connector.SchDoc, H_BRIDGE.SchDoc, POWER.SchDoc, RS485_CAN.SchDoc, Usb_To_UART.SchDoc, VIA_MOTORS.SchDoc]
2021-06-01 update firmware
    [CONNECTROS.SchDoc, POWER.SchDoc, RS485_CAN.SchDoc, Usb_To_UART.SchDoc, ad_via.PrjPcb, main_esp.SchDoc]
2021-07-10 update makerbot v1.1
    [CONNECTROS.SchDoc, POWER.SchDoc, RS485_CAN.SchDoc, Usb_To_UART.SchDoc, ad_via.PrjPcb, main_esp.SchDoc]
2021-10-22 update pcb
    [CONNECTROS.SchDoc, Mic_SPK.SchDoc, Mic_SPK2.SchDoc, POWER.SchDoc, RS485_CAN.SchDoc, Usb_To_UART.SchDoc, ad_via.PrjPcb, main_esp.SchDoc]
2022-04-23 update Design file for VRC2022
    [CONNECTORS.SchDoc, CONNECTROS.SchDoc, H-brigde_connector.SchDoc, H_BRIDGE.SchDoc, Mic_SPK.SchDoc, Mic_SPK2.SchDoc, POWER.SchDoc, RS485_CAN.SchDoc]
2022-05-14 fix reverse LED
2022-05-14 update tài liệu hướng dẫn
2022-05-16 update i2c scan
2022-05-16 cập nhật số lượng mạch hỏng
2023-05-06 fix overheating issue on DC motors drive circuit
    [Maker_bot_motor_test.ino]
2023-05-10 cập nhật hướng dẫn sử dụng chương trình mẫu
2023-06-05 update for VRC2023 PS2 wireless controller
2023-06-25 update motor test example with pio
